vt-amplab/basic-soldering-cert-board/README.md

basic-soldering-cert-board
==========================

Kicad files for the new basic soldering certification board
