vt-amplab/basic-soldering-cert-board/bom.xlsx

Component | Product Number | Vendor | Count | datasheet
BATT | 5702 | batteryspace | 1 | http://www.batteryspace.com/prod-specs/5702_5.pdf
TPD2E001 | 296-24770-1-ND | Digikey | 2 | http://www.ti.com/lit/ds/symlink/tpd2e001.pdf
104 | 399-1249-1-ND | Digikey | 8 | http://www.kemet.com/docfinder?Partnumber=C1206C104K5RACTU
102 | 399-4144-ND | Digikey | 1 | http://www.kemet.com/docfinder?Partnumber=C315C102K1R5TA
106 | 399-7443-1-ND | Digikey | 2 | http://www.kemet.com/docfinder?Partnumber=C1206C106M3RACTU
105 | 399-9714-ND | Digikey | 1 | http://capacitoredge.kemet.com/capedge2/DataSheet?pn=C315C105K3R5TA
103 | 399-9858-1-ND | Digikey | 1 | http://capacitoredge.kemet.com/capedge2/DataSheet?pn=C315C103K5R5TA7303
4k3 | 4.3KQBK-ND | Digikey | 3 | http://www.yageo.com/documents/recent/General%20Type_CFR.pdf
Test Points | 5000K-ND | Digikey | 14 | http://www.keyelco.com/userAssets/file/M60-2p60.pdf
1K | 541-1.00KFCT-ND | Digikey | 1 | http://www.vishay.com/doc?20035
100k | 541-100KFCT-ND | Digikey | 7 | http://www.vishay.com/doc?20035
10K | 541-1144-1-ND | Digikey | 1 | http://www.vishay.com/doc?33008
31k6 | 541-31.6KFCT-ND | Digikey | 1 | http://www.vishay.com/doc?20035
MIC2185 | 576-2162-ND | Digikey | 1 | http://www.micrel.com/_PDF/mic2185.pdf
427 | 718-1362-1-ND | Digikey | 1 | http://www.vishay.com/doc?40080
107 | 718-1885-1-ND | Digikey | 3 | http://www.vishay.com/docs/40080/tr3.pdf
USB OUT | A107360-ND | Digikey | 1 | http://www.te.com/commerce/DocumentDelivery/DDEController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
USB-IN | A108263CT-ND | Digikey | 1 | http://www.te.com/commerce/DocumentDelivery/DDEController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
B130 | B130-E3/5ATGICT-ND | Digikey | 1 | http://www.vishay.com/docs/88946/b120.pdf
1M | CMF1.00MHFCT-ND | Digikey | 1 | http://www.vishay.com/doc?31018
130k | CMF130KHFCT-ND | Digikey | 1 | http://www.vishay.com/doc?31018
34k | CMF34.0KHFCT-ND | Digikey | 1 | http://www.vishay.com/doc?31018
4k87 | CMF4.87KHFCT-ND | Digikey | 1 | http://www.vishay.com/doc?31018
FDC6392S | FDC6392SCT-ND | Digikey | 1 | http://www.fairchildsemi.com/ds/FD/FDC6392S.pdf
MCP6041 | MCP6041T-I/SNCT-ND | Digikey | 1 | http://ww1.microchip.com/downloads/en/DeviceDoc/21669D.pdf
10k | PPC10.0KZCT-ND | Digikey | 1 | http://www.vishay.com/doc?28724
4.7uH | SRR1240-4R7MCT-ND | Digikey | 1 | http://www.bourns.com/data/global/pdfs/SRR1240.pdf
0.01 | WSLP-.01CT-ND | Digikey | 1 | http://www.vishay.com/doc?30122
TPS2511 | 296-30552-1-ND | Digikey | 1 | http://www.ti.com/lit/ds/symlink/tps2511.pdf
LED | 754-1439-1-ND | Digikey | 13 | http://www.kingbrightusa.com/images/catalog/SPEC/APT3216QBC-D.pdf
1.5A | F2154CT-ND | Digikey | 1 | http://www.littelfuse.com/~/media/electronics/datasheets/resettable_ptcs/littelfuse_ptc_1812l_datasheet.pdf.pdf
3.0A | F4162CT-ND | Digikey | 1 | http://www.littelfuse.com/~/media/electronics/datasheets/resettable_ptcs/littelfuse_ptc_1812l_datasheet.pdf.pdf
LM3914 | LM3914N-1/NOPB-ND | Digikey | 1 | http://www.ti.com/lit/ds/symlink/lm3914.pdf
LT1389 | LT1389BCS8-5#PBF-ND | Digikey | 1 | http://www.linear.com/docs/1424
0.05 | LVK12R050DERCT-ND | Digikey | 1 | http://www.ohmite.com/cat/res_lvk.pdf
MAX9938 | MAX9938TEUK+TCT-ND | Digikey | 1 | http://datasheets.maximintegrated.com/en/ds/MAX9938.pdf
MCP73833 | MCP73833-FCI/UN-ND | Digikey | 1 | http://www.microchip.com/mymicrochip/filehandler.aspx?ddocname=en027983
SI4174DY | SI4174DY-T1-GE3CT-ND | Digikey | 1 | http://www.vishay.com/docs/68998/si4174dy.pdf
SI4463CDY | 78-SI4463CDY-T1-GE3 | Mouser | 2 | http://www.vishay.com/docs/67335/si4463cd.pdf
 |  |  | 84
