vt-amplab/basic-soldering-cert-board/power_supply.kicad_pcb

## KiCad design power_supply.kicad_pcb (2014-08-05)

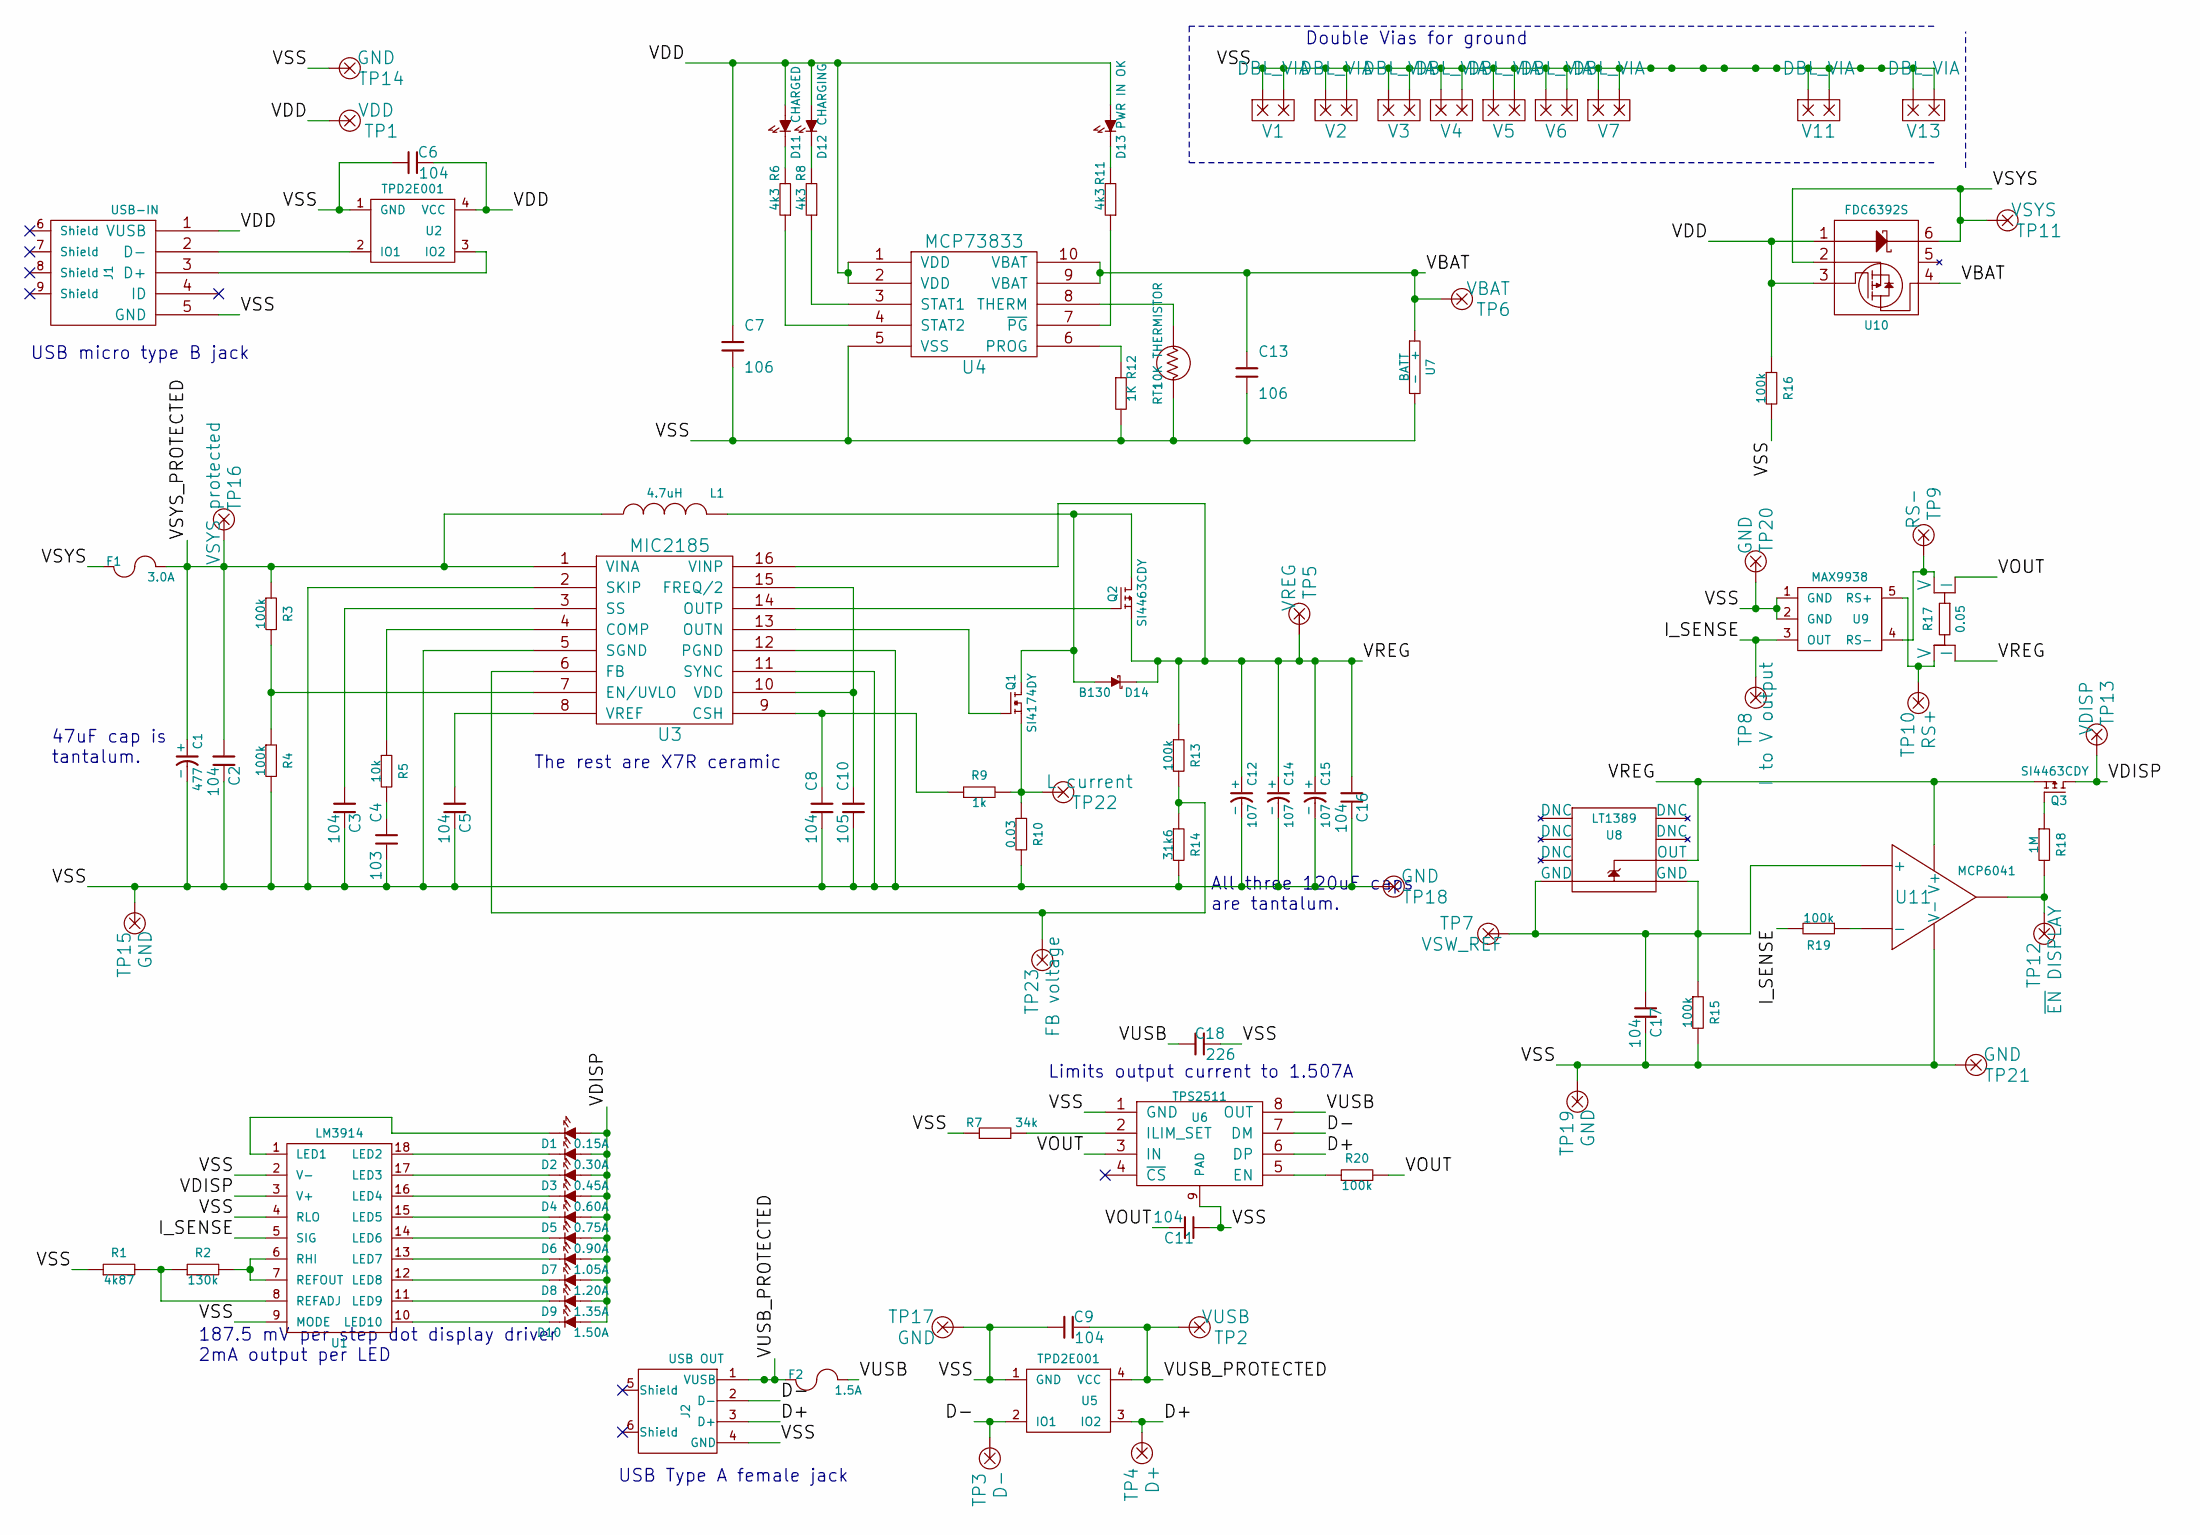
[picture p1: schematic power_supply.sch, USB Power Pack]

Parts:
C1: 477; c_2917_tant
C2, C3, C5, C6, C9, C11, C16, C17: 104; c_1206
C4: 103; cp_2.54mm
C7, C13: 106; c_1206
C8: 104; cp_2.54mm
C10: 105; cp_2.54mm
C12, C14, C15: 107; c_2924_tant
C18: 226; c_1206
D1: 0.15A; led_1206
D2: 0.30A; led_1206
D3: 0.45A; led_1206
D4: 0.60A; led_1206
D5: 0.75A; led_1206
D6: 0.90A; led_1206
D7: 1.05A; led_1206
D8: 1.20A; led_1206
D9: 1.35A; led_1206
D10: 1.50A; led_1206
D11: CHARGED; led_1206
D12: CHARGING; led_1206
D13: PWR IN OK; led_1206
D14: B130; diode_do41
F1: 3.0A; ptc_1812
F2: 1.5A; ptc_1812
J1: USB-IN; A108263CT(uUSB)
J2: USB OUT; A107360(USB-A)
L1: 4.7uH; ind_12.5mm
Q1: SI4174DY; si4174dy
Q2, Q3: SI4463CDY; si4463cdy
R1: 4k87; r_pth_2.5x6.5mm
R2: 130k; r_pth_2.5x6.5mm
R3, R4, R13, R15, R16, R19, R20: 100k; r_1206
R5: 10k; r_pth_2.5x6.5mm
R6, R8, R11: 4k3; r_pth_2.5x6.5mm
R7: 34k; r_pth_2.5x6.5mm
R9: 1k; r_1206
R10: 0.03; r_1206
R12: 1K; r_1206
R14: 31k6; r_1206
R17: 0.05; 1206-Kelvin
R18: 1M; r_pth_2.5x6.5mm
RT1: 10K THERMISTOR; r_1206
TP1: VDD; TP
TP2: VUSB; TP
TP3: D-; TP
TP4: D+; TP
TP5: VREG; TP
TP6: VBAT; TP
TP7: VSW_REF; TP
TP8: I to V output; TP
TP9: RS-; TP
TP10: RS+; TP
TP11: VSYS; TP
TP12: ~EN DISPLAY; TP
TP13: VDISP; TP
TP14, TP15, TP17, TP18, TP19, TP20, TP21: GND; TP
TP16: VSYS protected; TP
TP22: L current; TP
TP23: FB voltage; TP
U1: LM3914; PDIP-18
U2, U5: TPD2E001; TO-253-4
U3: MIC2185; so-16
U4: MCP73833; msop-10
U6: TPS2511; msop-8-powerpad
U7: BATT; BAT-18650-cylinder
U8: LT1389; so-8
U9: MAX9938; sot23-5
U10: FDC6392S; sot23-6
U11: MCP6041; so-8
V1, V2, V3, V4, V5, V6, V7, V11, V13: DBL_VIA

Connections:
/D+: J2.3 (D+), TP4.1, U5.3 (IO2), U6.6 (DP)
/D-: J2.2 (D-), TP3.1, U5.2 (IO1), U6.7 (DM)
/I_SENSE: R19.2, TP8.1, U1.5 (SIG), U9.3 (OUT)
/VBAT: C13.1, TP6.1, U4.9 (VBAT), U4.10 (VBAT), U7.1 (+), U10.4
/VDD: C6.2, C7.1, D11.1 (A), D12.1 (A), D13.1 (A), J1.1 (VUSB), R16.1, TP1.1, U2.4 (VCC), U4.1 (VDD), U4.2 (VDD), U10.1, U10.3
/VDISP: D1.1 (A), D2.1 (A), D3.1 (A), D4.1 (A), D5.1 (A), D6.1 (A), D7.1 (A), D8.1 (A), D9.1 (A), D10.1 (A), Q3.D, TP13.1, U1.3 (V+)
/VOUT: C11.2, R17.I2 (I), R20.2, U6.3 (IN)
/VREG: C12.1 (+), C14.1 (+), C15.1 (+), C16.1, D14.2, Q2.S, Q3.S, R13.1, R17.I1 (I), TP5.1, U3.16 (VINP), U8.6 (OUT), U11.7 (V+)
/VSS: C1.2 (-), C2.2, C3.2, C4.2, C5.2, C6.1, C7.2, C8.2, C9.1, C10.2, C11.1, C12.2 (-), C13.2, C14.2 (-), C15.2 (-), C16.2, C17.2, C18.2, J1.5 (GND), J2.4 (GND), R1.1, R4.2, R7.1, R10.2, R12.2, R14.2, R15.2, R16.2, RT1.2, TP14.1, TP15.1, TP17.1, TP18.1, TP19.1, TP20.1, TP21.1, U1.2 (V-), U1.4 (RLO), U1.9 (MODE), U2.1 (GND), U3.2 (SKIP), U3.5 (SGND), U3.11 (SYNC), U3.12 (PGND), U4.5 (VSS), U5.1 (GND), U6.1 (GND), U6.9 (PAD), U7.2 (-), U9.1 (GND), U9.2 (GND), U11.4 (V-), V1.1, V1.2, V2.1, V2.2, V3.1, V3.2, V4.1, V4.2, V5.1, V5.2, V6.1, V6.2, V7.1, V7.2, V11.1, V11.2, V13.1, V13.2
/VSYS: F1.1, TP11.1, U10.2, U10.6
/VSYS_PROTECTED: C1.1 (+), C2.1, F1.2, L1.1, R3.1, TP16.1, U3.1 (VINA)
/VUSB: C18.1, F2.2, U6.8 (OUT)
/VUSB_PROTECTED: C9.2, F2.1, J2.1 (VUSB), TP2.1, U5.4 (VCC)
unnamed: R11.1, U4.7 (~PG)
unnamed: D13.2 (K), R11.2
unnamed: R1.2, R2.1, U1.8 (REFADJ)
unnamed: R7.2, U6.2 (ILIM_SET)
unnamed: R20.1, U6.5 (EN)
unnamed: Q3.G, R18.1
unnamed: R12.1, U4.6 (PROG)
unnamed: RT1.1, U4.8 (THERM)
unnamed: D11.2 (K), R6.2
unnamed: D12.2 (K), R8.2
unnamed: D1.2 (K), U1.1 (LED1)
unnamed: R2.2, U1.6 (RHI), U1.7 (REFOUT)
unnamed: D5.2 (K), U1.15 (LED5)
unnamed: D10.2 (K), U1.10 (LED10)
unnamed: D9.2 (K), U1.11 (LED9)
unnamed: D8.2 (K), U1.12 (LED8)
unnamed: D7.2 (K), U1.13 (LED7)
unnamed: D6.2 (K), U1.14 (LED6)
unnamed: D4.2 (K), U1.16 (LED4)
unnamed: D3.2 (K), U1.17 (LED3)
unnamed: D2.2 (K), U1.18 (LED2)
unnamed: R17.V2 (V), TP9.1, U9.4 (RS-)
unnamed: R17.V1 (V), TP10.1, U9.5 (RS+)
unnamed: R13.2, R14.1, TP23.1, U3.6 (FB)
unnamed: J1.2 (D-), U2.2 (IO1)
unnamed: J1.3 (D+), U2.3 (IO2)
unnamed: R18.2, TP12.1, U11.6
unnamed: C17.1, R15.1, TP7.1, U8.4 (GND), U8.5 (GND), U11.3 (+)
unnamed: R19.1, U11.2 (-)
unnamed: R6.1, U4.4 (STAT2)
unnamed: Q1.G, U3.13 (OUTN)
unnamed: R5.1, U3.4 (COMP)
unnamed: C4.1, R5.2
unnamed: C5.1, U3.8 (VREF)
unnamed: C10.1, U3.10 (VDD), U3.15 (FREQ/2)
unnamed: Q2.G, U3.14 (OUTP)
unnamed: R3.2, R4.1, U3.7 (EN/UVLO)
unnamed: C3.1, U3.3 (SS)
unnamed: R8.1, U4.3 (STAT1)
unnamed: D14.1, L1.2, Q1.D, Q2.D
unnamed: C8.1, R9.1, U3.9 (CSH)
unnamed: Q1.S, R9.2, R10.1, TP22.1

Notes on the sheet:
187.5 mV per step dot display driver 2mA output per LED
USB Type A female jack
USB micro type B jack
All three 120uF caps are tantalum.
47uF cap is tantalum.
Limits output current to 1.507A
The rest are X7R ceramic
Double Vias for ground

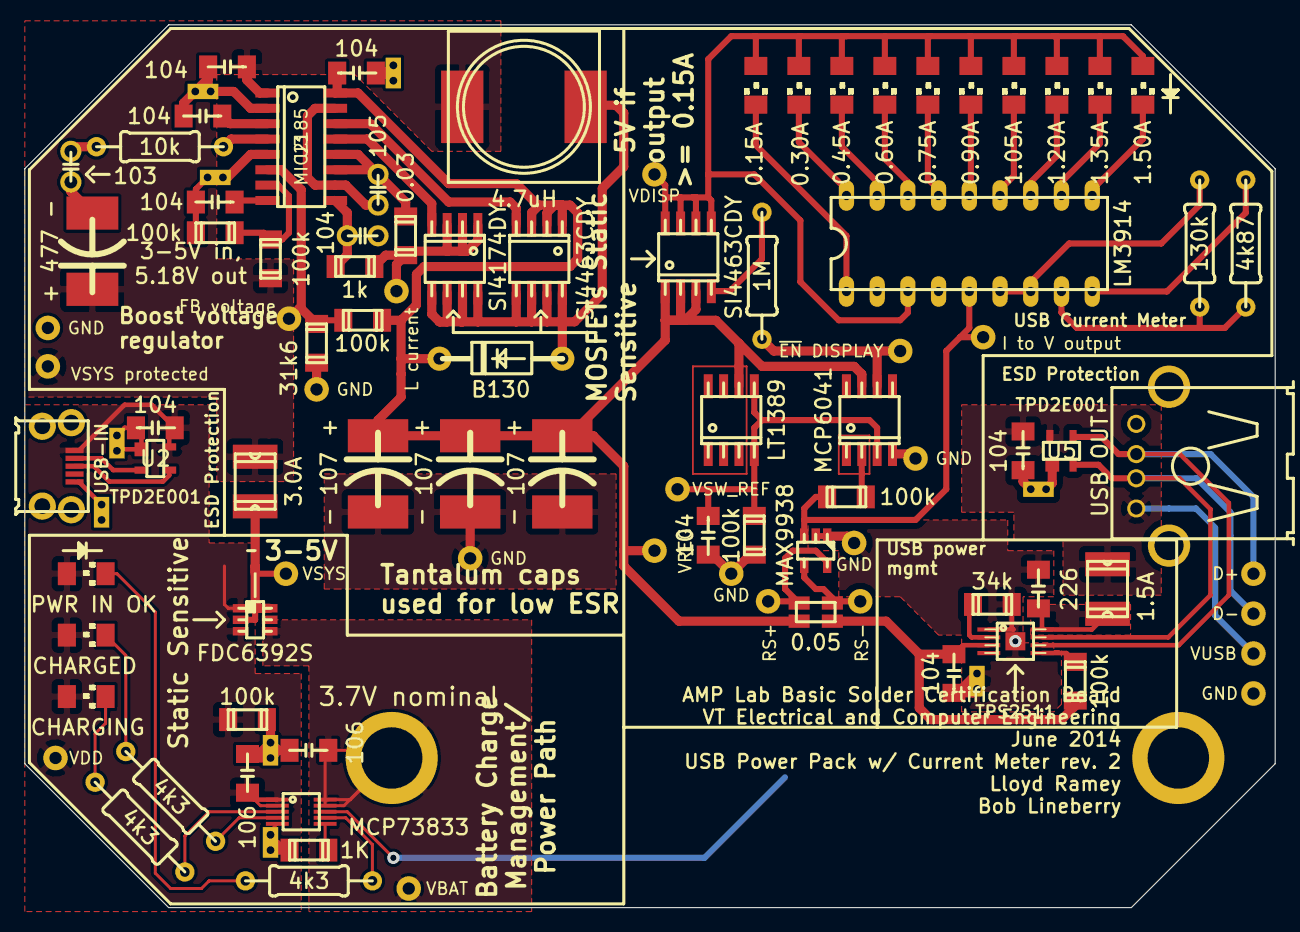
[picture p2: board power_supply.kicad_pcb from above]

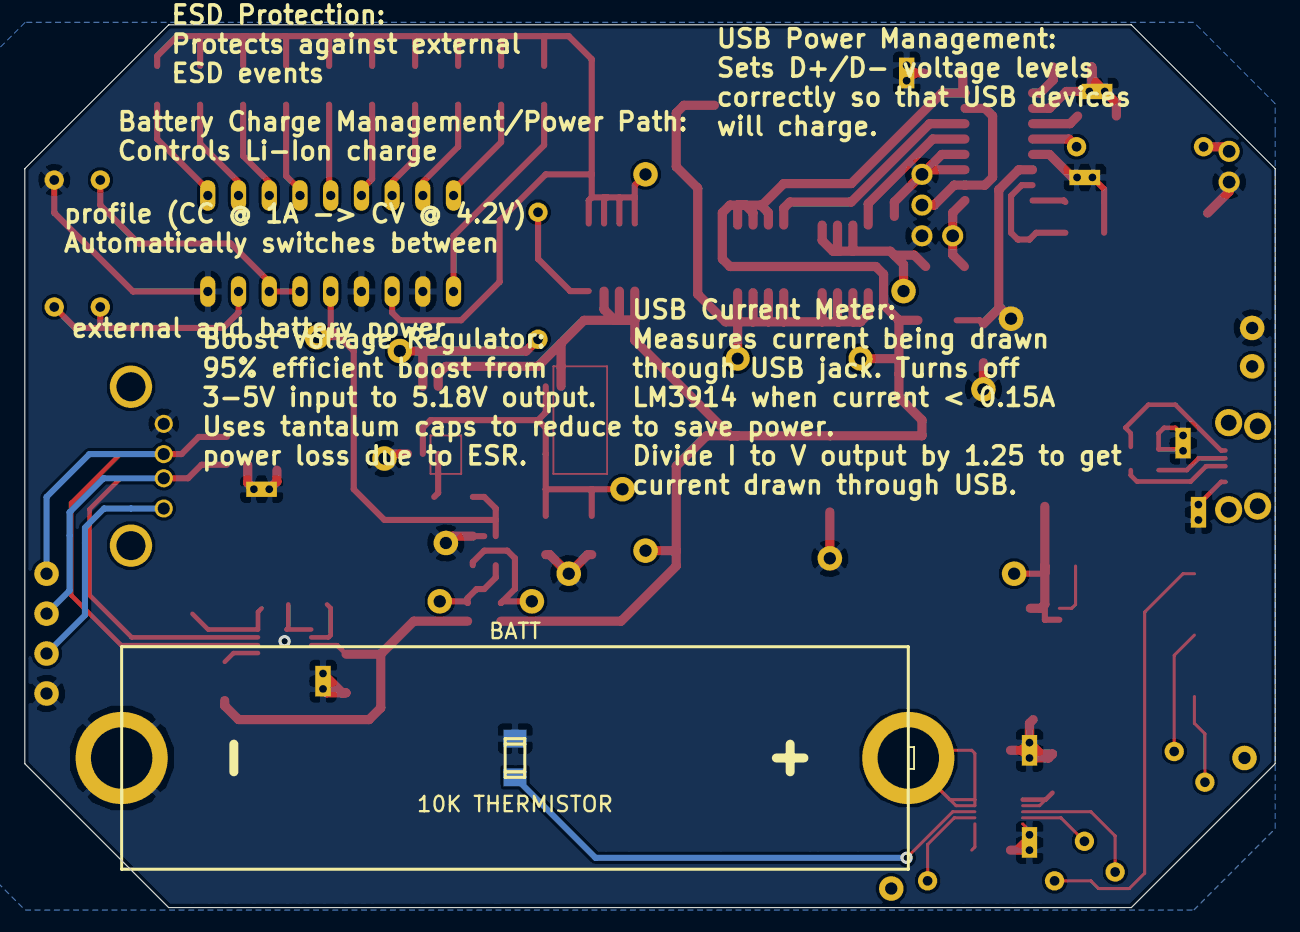
[picture p3: board power_supply.kicad_pcb from below]

Board: 2 copper layers, 103.4 x 73.0 mm, 104 parts (2 on the bottom side), 55 nets.
