vt-amplab/basic-soldering-cert-board/(commit log)

2014-03-24 Beginning PCB.
    Need to get dimensions of breadboard
    [connectors.sch, hyperion.kicad_pcb, hyperion.sch, monitor.sch, power_regulator.sch]
2014-03-31 Rearranged, added a few things (look at long msg).
    Renamed to power_supply (boring, but more professional).
    Rearranged schematic to look somewhat organized.
    Added more description.
    Added Li-Ion charger circuit.
    Added Phone charger output w/ adjustable resistors on data lines.
    Added over voltage protection for phone charger and Li-Ion charger (cuts
    these two off at 5.1V.
    Switched to terminal block for output.
    [connectors.sch, hyperion.kicad_pcb, hyperion.sch, monitor.sch, power_regulator.sch, power_supply.sch]
2014-03-31 Corrected name.
    Rearranged schematic.
    [power_supply.sch]
2014-03-31 Updated schematic
    [power_supply.sch]
2014-03-31 Updated from bob feedback
    [monitor.sch, power_supply.sch]
2014-04-21 Updating to new design
    [monitor.sch, power_supply.sch]
2014-06-13 Purged rev 1 to begin rev 2
    [monitor.sch, power_supply.sch]
2014-06-13 Updated libraries
    [power_supply.sch]
2014-06-13 MSP73833 circuit stuff
    [power_supply.sch]
2014-06-14 Updated library. Began adding components.
    [power_supply.sch]
2014-06-15 Power Supply Schematic
    Completed schematic up through the MIC2185
    Regulated output voltage named VpREG
    Custom components listed in power_supply-cache.lib
    [$power_supply.sch, LED_Array.sch, NMOS_Transistors.sch, PMOS_Transistors.sch, power_supply.sch]
2014-06-15 Updated component library
    [$power_supply.sch, LED_Array.sch, NMOS_Transistors.sch, PMOS_Transistors.sch, power_supply.sch]
2014-06-16 Finished schematic
    [NMOS_Transistors.sch, PMOS_Transistors.sch, li-ion-power-path.sch, power_supply.kicad_pcb, power_supply.sch]
2014-06-17 Added ESD protection to input and output.
    [power_supply.sch]
2014-06-17 Updated comments
    [power_supply.sch]
2014-06-17 Updated product numbers
    Also modified current sense schematic to reflect eval board suggestions
    [power_supply.sch]
2014-06-17 Added LM3914 digikey product number
    [power_supply.sch]
2014-06-17 Added comments
    [power_supply.sch]
2014-06-18 Updating based on Bob's feedback
    [power_supply.sch]
2014-06-18 Added turn off for display when no current is being drawn
    [power_supply.sch]
2014-06-18 Fixed a few issues with printout
    [power_supply.sch]
2014-06-18 Fixed ERC errors
    [power_supply.sch]
2014-06-19 Updated comparator circuit to add histeresis.
    Should turn on at .187V and off at .157V
    [power_supply.sch]
2014-06-19 Updated display auto-off circuit, added part numbers
    [power_supply.csv, power_supply.sch]
2014-06-20 Began creating footprints
    [power_supply.csv, power_supply_BOM.ods]
2014-06-20 Finished footprints. Began layout
    [power_supply.sch]
2014-06-20 Finished rev1 layout
    [power_supply.kicad_pcb, power_supply.sch]
2014-06-21 Began routing.
    Fixed a few footprint issues.
    Added through hole vias.
    [power_supply.kicad_pcb, power_supply.sch]
2014-06-22 More routing work
    [power_supply.kicad_pcb, power_supply.sch]
2014-06-22 Finished routing
    [power_supply.kicad_pcb, power_supply.sch]
2014-06-24 Fixed issues in response to Bob's comments
    [power_supply.kicad_pcb, power_supply.sch]
2014-06-24 More fixes
    [power_supply.sch]
2014-06-24 Added test points
    [power_supply.kicad_pcb, power_supply.sch]
2014-06-25 Added silkscreen
    [power_supply.kicad_pcb, power_supply.sch]
2014-06-26 Updated silkscreen
    [power_supply.kicad_pcb]
2014-06-26 Removed unused files
    [NMOS_Transistors.sch, PMOS_Transistors.sch, li-ion-power-path.sch]
2014-06-29 Corrected rsense for regulator
    [power_supply.kicad_pcb, power_supply.sch]
2014-07-17 Updated files
    [bom.xlsx, power_supply.kicad_pcb, power_supply.sch]
2014-07-28 Reshaping board
    [power_supply.kicad_pcb, power_supply.sch]
2014-07-28 Filled ground plane
    [power_supply.kicad_pcb]
2014-07-28 Fixed silkscreen after reshaping
    [power_supply.kicad_pcb]
2014-07-30 Updated schematic
    Added output capacitor onto TPS2511, pull up on EN
    Updated board shape
    [power_supply.kicad_pcb, power_supply.sch, power_supply_BOM.ods]
2014-08-01 Fixed schematic, PCB, and library TPS2511
    TPS2511 GND and VCC were switched.
    [power_supply.kicad_pcb, power_supply.sch]
2014-08-01 Fixed MAX9938
    RS+/RS- reversed
    [power_supply.kicad_pcb, power_supply.sch]
2014-08-01 Fixed test points for RS+/-
    Reversed
    [power_supply.kicad_pcb, power_supply.sch]
